remidebord/GPS-Clock/Hardware/mapping/V1.0/gpsclock.xlsx

Pin | Port | Peripheral | Function
1 | VBAT | Supply for RTC
2 | PC13 | FREE
3 | PC14 | FREE
4 | PC15 | FREE
5 | PF0 | FREE
6 | PF1 | FREE
7 | NRST | NRST | NRST
8 | VSSA | GND ADC -> = VSS
9 | VDDA | Alim ADC -> = VDD
10 | PA0 | GPIO_EXTI0 | Rotary encoder | Clock settings
11 | PA1 | GPIO_EXTI1 | Rotary encoder | Clock settings
12 | PA2 | GPIO_Input | Rotary encoder (push button) | Clock settings
13 | PA3 | TIM15_CH2 - PWM | Luminosity
14 | PA4 | GPIO_Ouptut | Seven segment (A)
15 | PA5 | GPIO_Ouptut | Seven segment (F)
16 | PA6 | GPIO_Ouptut | Seven segment (B)
17 | PA7 | GPIO_Ouptut | Seven segment (D4)
18 | PB0 | GPIO_Ouptut | Seven segment (D3)
19 | PB1 | GPIO_Ouptut | Seven segment (D2)
20 | PB2 | GPIO_Ouptut | Seven segment (D1)
21 | PB10 | FREE
22 | PB11 | FREE
23 | VSS | GND
24 | VDD | Alim 3V3
25 | PB12 | FREE
26 | PB13 | FREE
27 | PB14 | GPIO_Ouptut | Seven segment (G)
28 | PB15 | GPIO_Ouptut | Seven segment (C)
29 | PA8 | GPIO_Ouptut | Seven segment (DP)
30 | PA9 | UART1_TX | GPS communication
31 | PA10 | UART1_RX | GPS communication
32 | PA11 | GPIO_Ouptut | Seven segment (D)
33 | PA12 | GPIO_Ouptut | Seven segment (E)
34 | PA13 |  | SYS_SWDIO
35 | PF6 | I2C2_SCL | RTC (DS3231)
36 | PF7 | I2C2_SDA | RTC (DS3231)
37 | PA14 |  | SYS_SWCLK
38 | PA15 | FREE
39 | PB3 | FREE
40 | PB4 | GPIO_EXTI4 | RTC (DS3231) 1Hz pulse
41 | PB5 | GPIO_Input | Rotary encoder (push button) | Radio & Luminosity
42 | PB6 | FREE
43 | PB7 | FREE
44 | BOOT0 | Boot Mode
45 | PB8 | GPIO_EXTI8 | Rotary encoder | Radio & Luminosity
46 | PB9 | GPIO_EXTI9 | Rotary encoder | Radio & Luminosity
47 | VSS | GND
48 | VDD | Alim 3V3
