remidebord/GPS-Clock/Hardware/bom/bom.1.0.xlsx

Qty | Price/unit (€) | Price (€) | Stock | Value | Package | Parts | Description | RS | Réf
1 | 0.09 | 0.09 | 50 |  | CHIPLED_1206 | LED1 | LED | 692-1098
1 | 0 | 0 | 100 |  | 1X02 | BOOT0 | PIN HEADER | /
3 | 0 | 0 | 100 |  | 1X04 | GPS, I2C, SWD | PIN HEADER | /
1 | 2.6 | 2.6 | 2 | 0.1F or 0.22F | CPOL-RADIAL-1000UF-25V | C3 | Capacitor Polarized | 867-5463
8 | 0.01 | 0.08 | 42 | 100 or 200 | R1206 | R3, R4, R5, R6, R9, R10, R11, R12 | RESISTOR, American symbol | 740-9079 | CR1206-FX-1000ELF
4 | 0.02 | 0.08 | 50 | 100k | R1206 | R2, R19, R20, R21 | RESISTOR, American symbol | 740-9114 | CR1206-JW-104GLF
3 | 0.08 | 0.24 | 49 | 100nF | C1206 | C5, C7, C8 | CAPACITOR, European symbol | 464-6852 | 12065C104JAT1A
1 | 0.03 | 0.03 | 24 | 10nF | C0805 | C6 | CAPACITOR, European symbol | 264-4371 | C0805C103K5RACTU
4 | 0.02 | 0.08 | 46 | 1k | R1206 | R13, R14, R15, R16 | RESISTOR, American symbol | 740-9088 | CR1206-FX-1001ELF
1 | 0.03 | 0.03 | 48 | 1uF | C0805 | C4 | CAPACITOR, European symbol | 691-1167 | C0805C105K3RACTU
1 | 0.13 | 0.13 | 89 | 330 | R1206 | R1 | RESISTOR, American symbol | 8121871 | CRCW1206330RFKEAHP
2 | 0.01 | 0.02 | 49 | 4.7k | R0805 | R7, R8 | RESISTOR, American symbol | 223-0528 | CRG0805F4K7
1 | 3.64 | 3.64 | 1 | 7-SEGMENT-4DIGIT-COUNTER | CC56-21SURKWA | 7SEG |  | 8722014 | CC56-21SURKWA
2 | 0.31 | 0.62 | 49 | BAT20J | SOD323_ST | D1, D2 | Schottky barrier diode | 714-6844 | BAT20JFILM
4 | 0.12 | 0.48 | 24 | BC817-25SMD | SOT23-BEC | Q1, Q2, Q3, Q4 | NPN Transistor | 690-0076 | BC817-25LT3G
1 | 10.24 | 10.24 | 3 | DS3231/SO | SO16W | IC2 |  | 732-7582 | DS3231SN#
2 | 2.16 | 4.32 | 6 | EC12E_SW | PEC11R-4215F-S0024 | RADIO, SETTINGS | Bourns rotary Encoder PEC11R series with switch | 737-7748 | PEC11R-4215F-S0024
1 | 0.62 | 0.62 | 4 | LD398533RG | TSOT23-5L | IC3 | Ultra low drop and low noise BiCMOS voltage regulators | 686-8802 | LD3985M33R
1 | 0.38 | 0.38 | 9 | NRST | TACTILE-SWITCH-SMD | S1 | Various NO switches- pushbuttons, reed, etc | 758-2060 | SKQGAFE010
1 | 1.83 | 1.83 | 4 | STM32F051C8T | LQFP48 | IC1 | ARM 32-bit Cortex™-M0 CPU | 761-8658 | STM32F051C8T6
1 | 1.17 | 1.17 | 4 | USBSMD | USB-MINIB | JP1 | USB Connectors | 670-2654 | 67503-1230
 | Total | 26.68 | €
 | PCB | 7.76 | € | > OSH (23,30€ pour 3)
 | Plexi | 2.48 | € | > Damengo (9,95€ pour 4)
 | Vis | 3 | € | > http://www.futurlec.com/Hardware.shtml (2€ pour 12 entretoises + vis) + Bricovis (1€)
 | GPS | 17 | € | > TxHang Electronic (ebay) => version NEO M8N
 | Total | 56.92 | €
