remidebord/GPS-Clock/Hardware/eagle/V1.0/gpsclock.brd

## EAGLE design Hardware/eagle/V1.0/gpsclock.brd (2016-12-22)

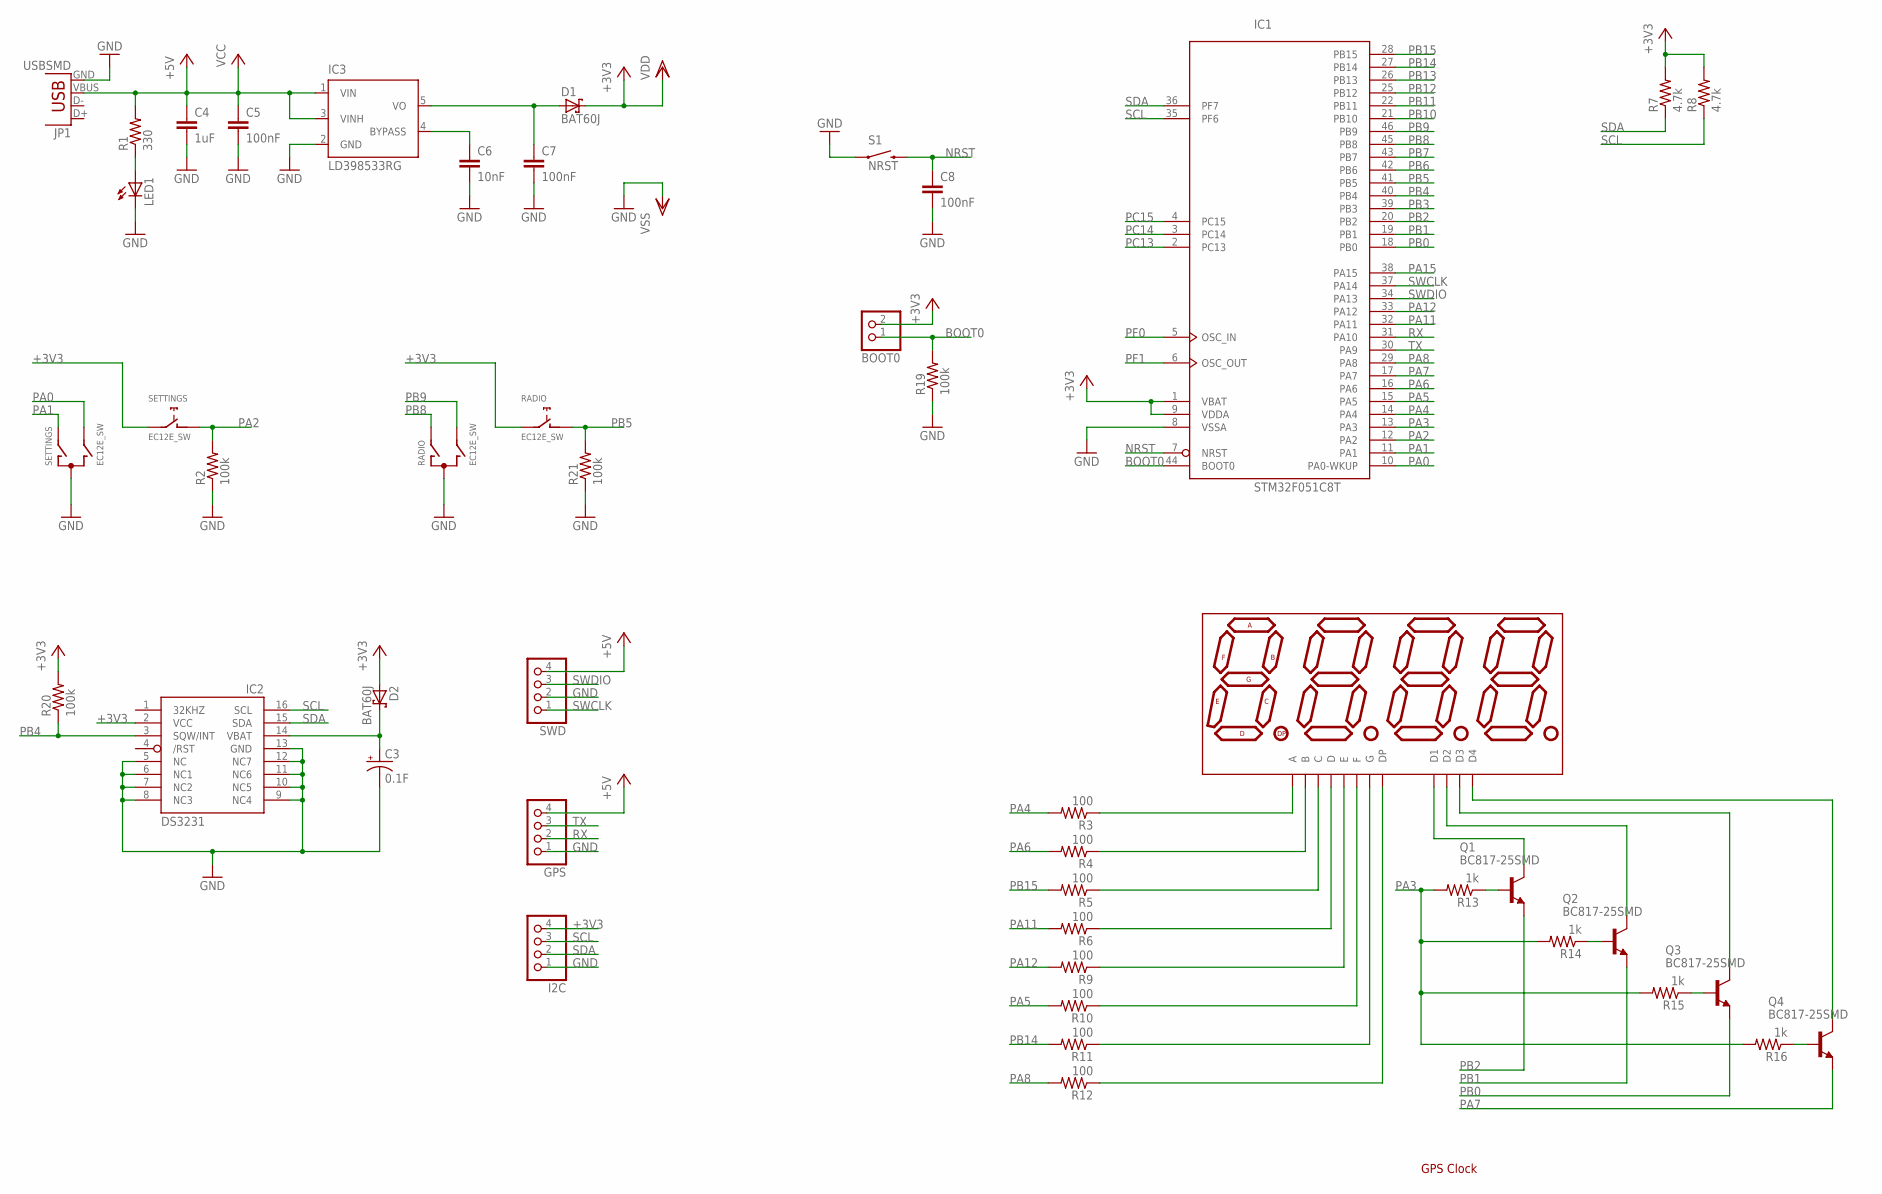
[picture p1: schematic gpsclock.sch]

Parts:
7SEG: 7-SEGMENT-4DIGIT-COUNTER; CC56-21SURKWA
BOOT0: PINHD-1X2; 1X02
C3: 0.1F; CPOL-RADIAL-1000UF-25V
C4: 1uF; C0805
C5, C7, C8: 100nF; C1206
C6: 10nF; C0805
D1, D2: BAT60J; SOD323_ST
GPS: PINHD-1X4; 1X04
I2C: PINHD-1X4; 1X04
IC1: STM32F051C8T; LQFP48
IC2: DS3231/SO; SO16W
IC3: LD398533RG; TSOT23-5L
JP1: USBSMD; USB-MINIB
LED1: LEDCHIPLED_1206; CHIPLED_1206
Q1, Q2, Q3, Q4: BC817-25SMD; SOT23-BEC
R1: 330; R1206
R2, R19, R20, R21: 100k; R1206
R3, R4, R5, R6, R9, R10, R11, R12: 100; R1206
R7, R8: 4.7k; R0805
R13, R14, R15, R16: 1k; R1206
RADIO: EC12E_SW; ALPS_EC12E_SW
S1: NRST; TACTILE-SWITCH-SMD
SETTINGS: EC12E_SW; ALPS_EC12E_SW
SWD: PINHD-1X4; 1X04

Connections:
+3V3: BOOT0.2, D1.C, D2.A, I2C.4, IC1.1 (VBAT), IC1.9 (VDDA), IC1.24 (VDD), IC1.48 (VDD), IC2.2 (VCC), R7.2, R8.2, R20.2, RADIO.E (2), SETTINGS.E (2)
+5V: C4.1, C5.1, GPS.4, IC3.1 (VIN), IC3.3 (VINH), JP1.VBUS, R1.2, SWD.4
BOOT0: BOOT0.1, IC1.44 (BOOT0), R19.2
GND: C3.2 (-), C4.2, C5.2, C6.2, C7.2, C8.2, GPS.1, I2C.1, IC1.8 (VSSA), IC1.23 (VSS), IC1.47 (VSS), IC2.5 (NC), IC2.6 (NC1), IC2.7 (NC2), IC2.8 (NC3), IC2.9 (NC4), IC2.10 (NC5), IC2.11 (NC6), IC2.12 (NC7), IC2.13 (GND), IC3.2 (GND), JP1.GND, LED1.C, R2.1, R19.1, R21.1, RADIO.C, S1.1, S1.2 (1), SETTINGS.C, SWD.2
unnamed: 7SEG.10 (F), R10.1
unnamed: 7SEG.9 (D2), Q2.C
unnamed: 7SEG.6 (D4), Q4.C
unnamed: LED1.A, R1.1
unnamed: Q2.B, R14.1
unnamed: 7SEG.11 (A), R3.1
unnamed: 7SEG.7 (B), R4.1
unnamed: C6.1, IC3.4 (BYPASS)
unnamed: C7.1, D1.A, IC3.5 (VO)
unnamed: 7SEG.4 (C), R5.1
unnamed: 7SEG.2 (D), R6.1
unnamed: 7SEG.1 (E), R9.1
unnamed: 7SEG.5 (G), R11.1
unnamed: 7SEG.3 (DP), R12.1
unnamed: Q3.B, R15.1
unnamed: 7SEG.8 (D3), Q3.C
unnamed: C3.1 (+), D2.C, IC2.14 (VBAT)
unnamed: Q1.B, R13.1
unnamed: 7SEG.12 (D1), Q1.C
unnamed: Q4.B, R16.1
NRST: C8.1, IC1.7 (NRST), S1.3 (2), S1.4 (2)
PA0: IC1.10 (PA0-WKUP), SETTINGS.B
PA1: IC1.11 (PA1), SETTINGS.A
PA2: IC1.12 (PA2), R2.2, SETTINGS.D (1)
PA3: IC1.13 (PA3), R13.2, R14.2, R15.2, R16.2
PA4: IC1.14 (PA4), R3.2
PA5: IC1.15 (PA5), R10.2
PA6: IC1.16 (PA6), R4.2
PA7: IC1.17 (PA7), Q4.E
PA8: IC1.29 (PA8), R12.2
PA11: IC1.32 (PA11), R6.2
PA12: IC1.33 (PA12), R9.2
PA15: IC1.38 (PA15)
PB0: IC1.18 (PB0), Q3.E
PB1: IC1.19 (PB1), Q2.E
PB2: IC1.20 (PB2), Q1.E
PB3: IC1.39 (PB3)
PB4: IC1.40 (PB4), IC2.3 (SQW/INT), R20.1
PB5: IC1.41 (PB5), R21.2, RADIO.D (1)
PB6: IC1.42 (PB6)
PB7: IC1.43 (PB7)
PB8: IC1.45 (PB8), RADIO.A
PB9: IC1.46 (PB9), RADIO.B
PB10: IC1.21 (PB10)
PB11: IC1.22 (PB11)
PB12: IC1.25 (PB12)
PB13: IC1.26 (PB13)
PB14: IC1.27 (PB14), R11.2
PB15: IC1.28 (PB15), R5.2
PC13: IC1.2 (PC13)
PC14: IC1.3 (PC14)
PC15: IC1.4 (PC15)
PF0: IC1.5 (OSC_IN)
PF1: IC1.6 (OSC_OUT)
RX: GPS.2, IC1.31 (PA10)
SCL: I2C.3, IC1.35 (PF6), IC2.16 (SCL), R8.1
SDA: I2C.2, IC1.36 (PF7), IC2.15 (SDA), R7.1
SWCLK: IC1.37 (PA14), SWD.1
SWDIO: IC1.34 (PA13), SWD.3
TX: GPS.3, IC1.30 (PA9)

Notes on the sheet:
GPS Clock

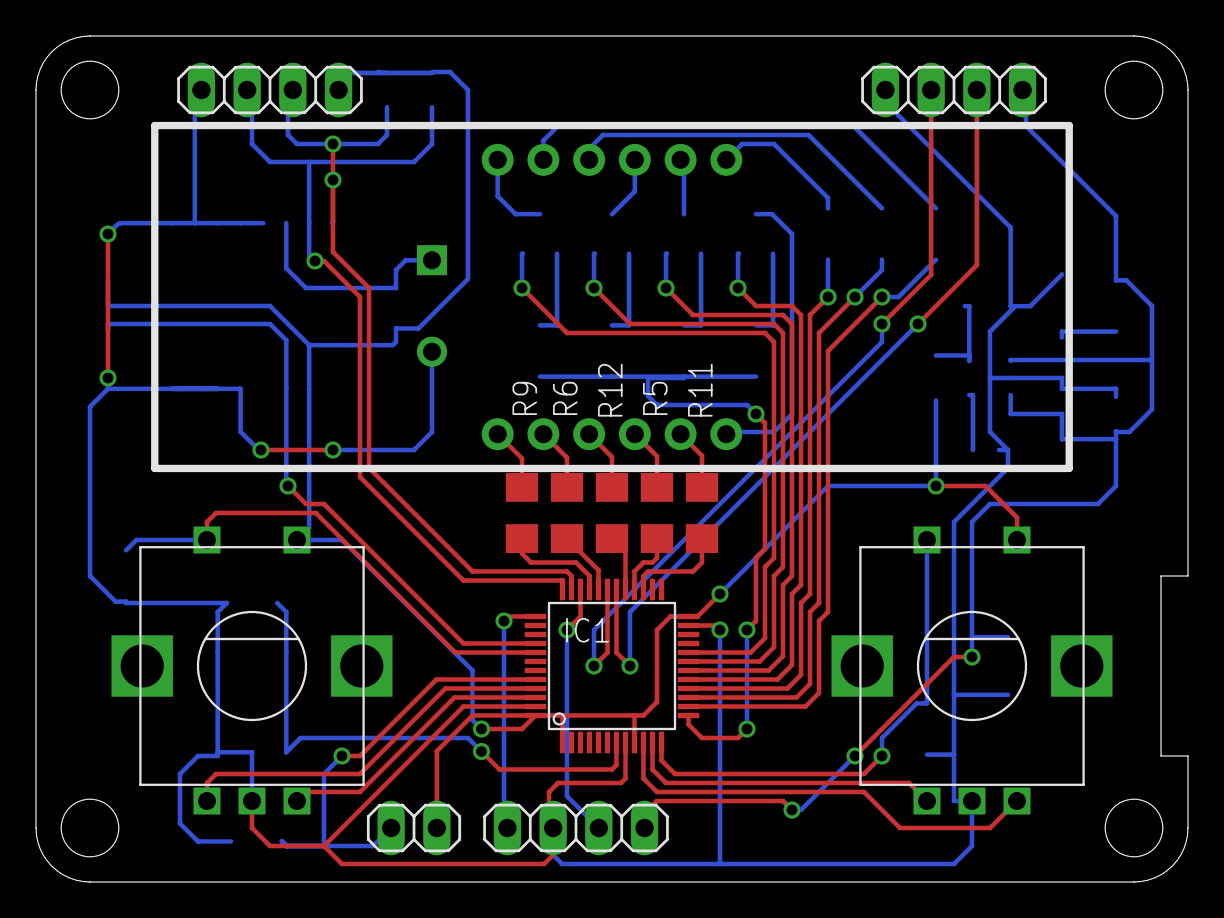
[picture p2: board gpsclock.brd from above]

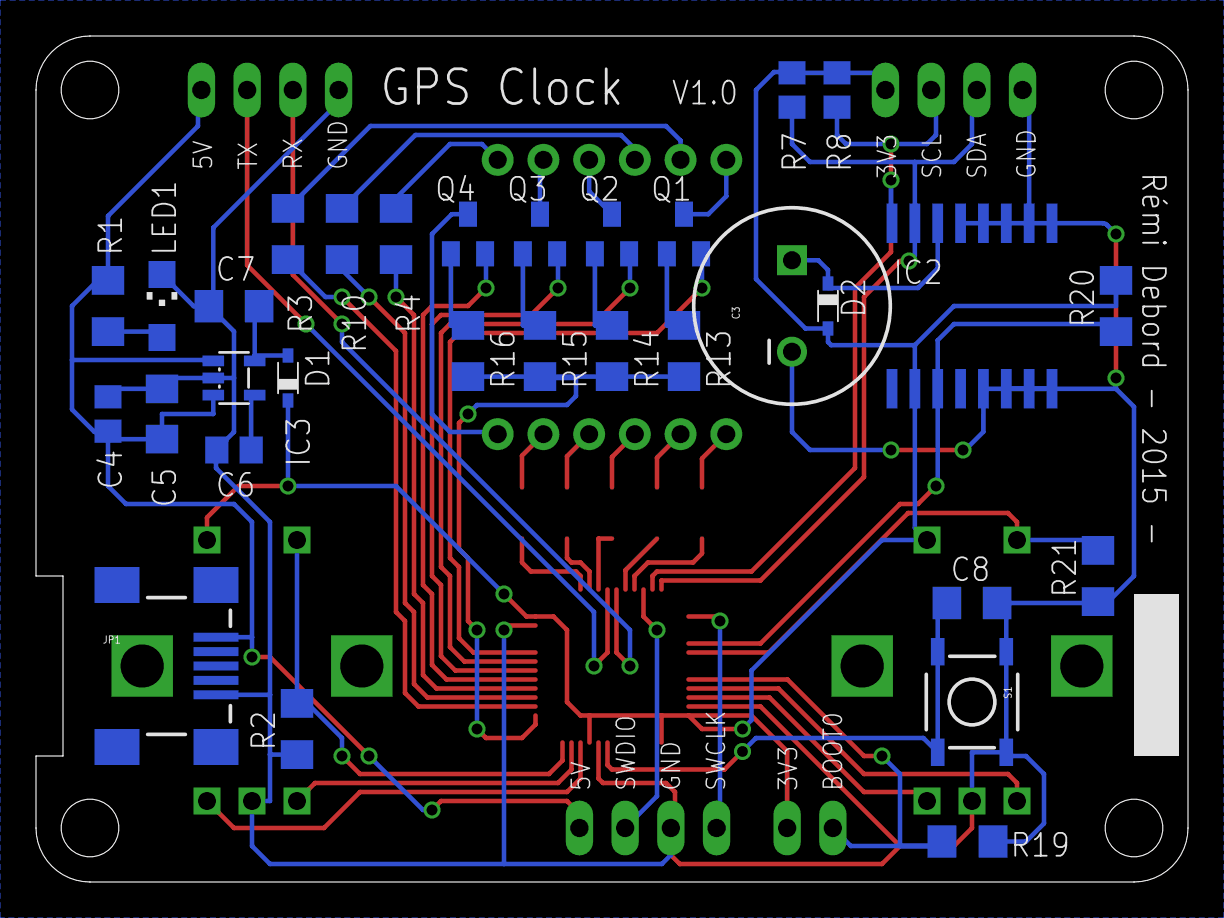
[picture p3: board gpsclock.brd from below]

Board: 2 copper layers, 64.0 x 47.0 mm, 44 parts (31 on the bottom side), 51 nets.
