remidebord/GPS-Clock/Hardware/mapping/V1.0/gpsclock.ioc

Mcu.UserName=STM32F051C8Tx
PA0.Signal=GPXTI0
PA1.Signal=GPXTI1
PA10.Signal=USART1_RX
PA11.Signal=GPIO_Output
PA12.Signal=GPIO_Output
PA13.Signal=SYS_SWDIO
PA14.Signal=SYS_SWCLK
PA2.Signal=GPIO_Input
PA3.Signal=S_TIM15_CH2
PA4.Signal=GPIO_Output
PA5.Signal=GPIO_Output
PA6.Signal=GPIO_Output
PA7.Signal=GPIO_Output
PA8.Signal=GPIO_Output
PA9.Signal=USART1_TX
PB0.Signal=GPIO_Output
PB1.Signal=GPIO_Output
PB14.Signal=GPIO_Output
PB15.Signal=GPIO_Output
PB2.Signal=GPIO_Output
PB4.Signal=GPXTI4
PB5.Signal=GPIO_Input
PB8.Signal=GPXTI8
PB9.Signal=GPXTI9
PF6.Signal=I2C2_SCL
PF7.Signal=I2C2_SDA
