remidebord/GPS-Clock/Software/STM32/inc/cie1931.h

// CIE1931 correction table

const unsigned char cie[101] = {0,0,0,0,0,1,1,1,1,1,
																1,1,1,2,2,2,2,2,3,3,
																3,3,4,4,4,4,5,5,5,6,
																6,7,7,8,8,8,9,10,10,11,
																11,12,12,13,14,15,15,16,17,18,
																18,19,20,21,22,23,24,25,26,27,
																28,29,30,32,33,34,35,37,38,39,
																41,42,44,45,47,48,50,52,53,55,
																57,58,60,62,64,66,68,70,72,74,
																76,78,81,83,85,88,90,92,95,97,
																100};
